miku993/Multiple-waveform-generators/image/电源/240V-12V AC-DC纹波图.jpg

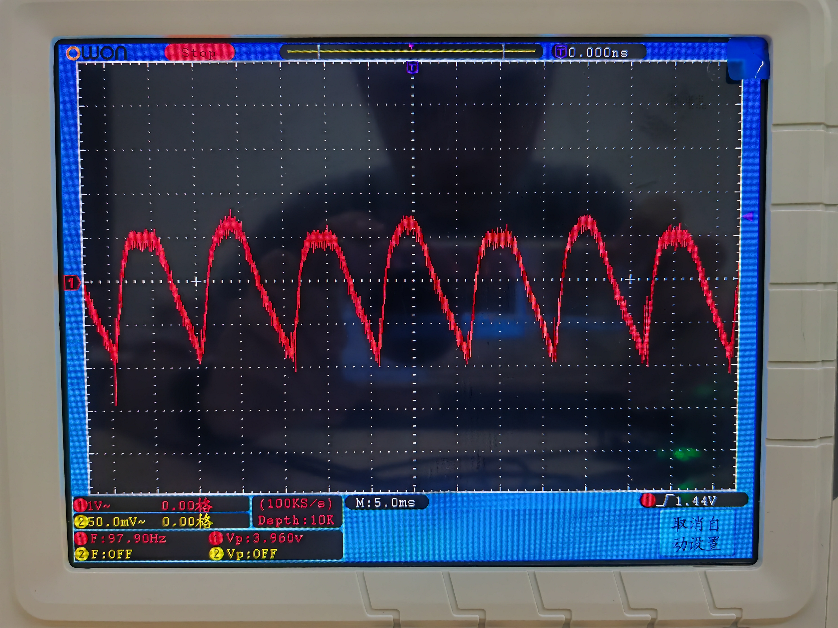
image/电源/240V-12V AC-DC纹波图.jpg
