miku993/Multiple-waveform-generators/image/正弦波/正弦波最低频率--15.5Hz.jpg

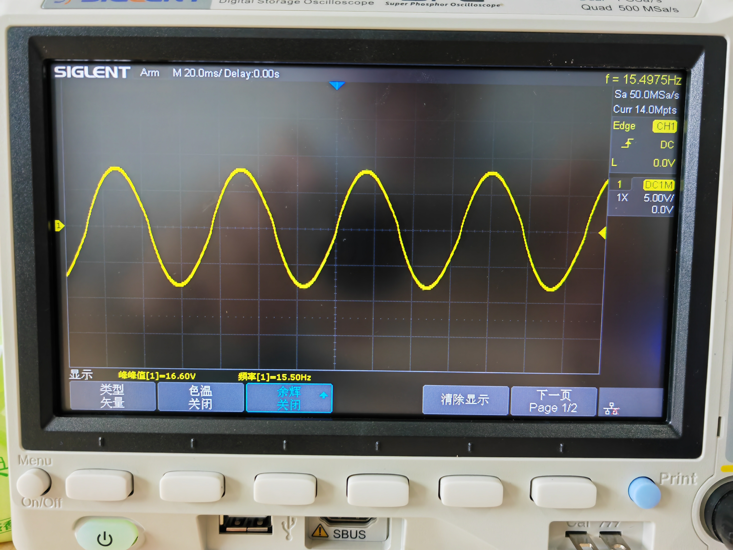
image/正弦波/正弦波最低频率--15.5Hz.jpg
