miku993/Multiple-waveform-generators/README.md

# 纯模电方法实现多种波形发生器
1. 输出波形工作频率范围为0.02Hz~20KHz，且连续可调。 
2. 正弦波Upp=3V，失真度小于1.5%，幅值连续可调。 
3. 方波幅值Upp=14V，幅值连续可调。 
4. 三角波Upp=5V，幅值连续可调  
### 基本功能可以实现，部分频段波形失真。工程包括仿真文件、pcb、原理图、论文，体系完备，有细致分析，全部免费开源。
