miku993/Multiple-waveform-generators/image/PCB+原理图+实物+仿真/PCB板实物图.jpg

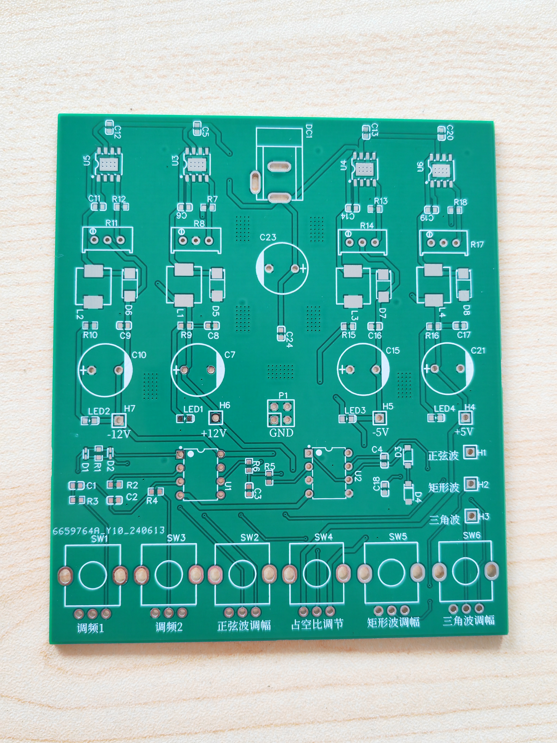
image/PCB+原理图+实物+仿真/PCB板实物图.jpg
