miku993/Multiple-waveform-generators/image/PCB+原理图+实物+仿真/PCB设计图.png

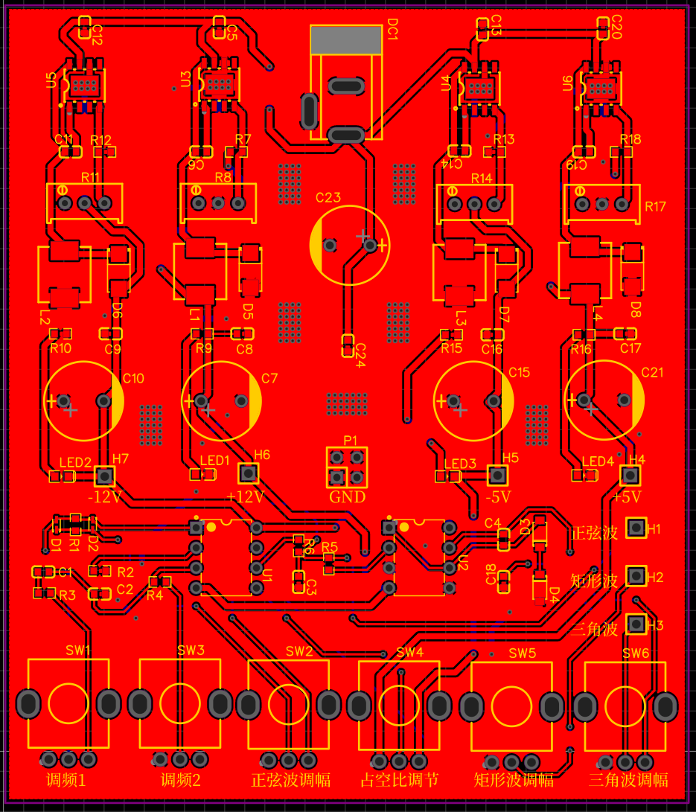
image/PCB+原理图+实物+仿真/PCB设计图.png
