miku993/Multiple-waveform-generators/image/多种波形叠加效果图.jpg

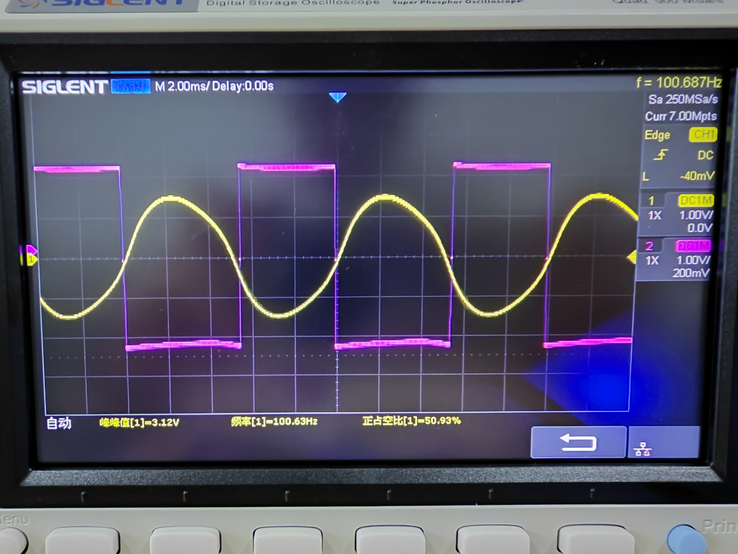
image/多种波形叠加效果图.jpg
