miku993/Multiple-waveform-generators/image/框图/电源框图.png

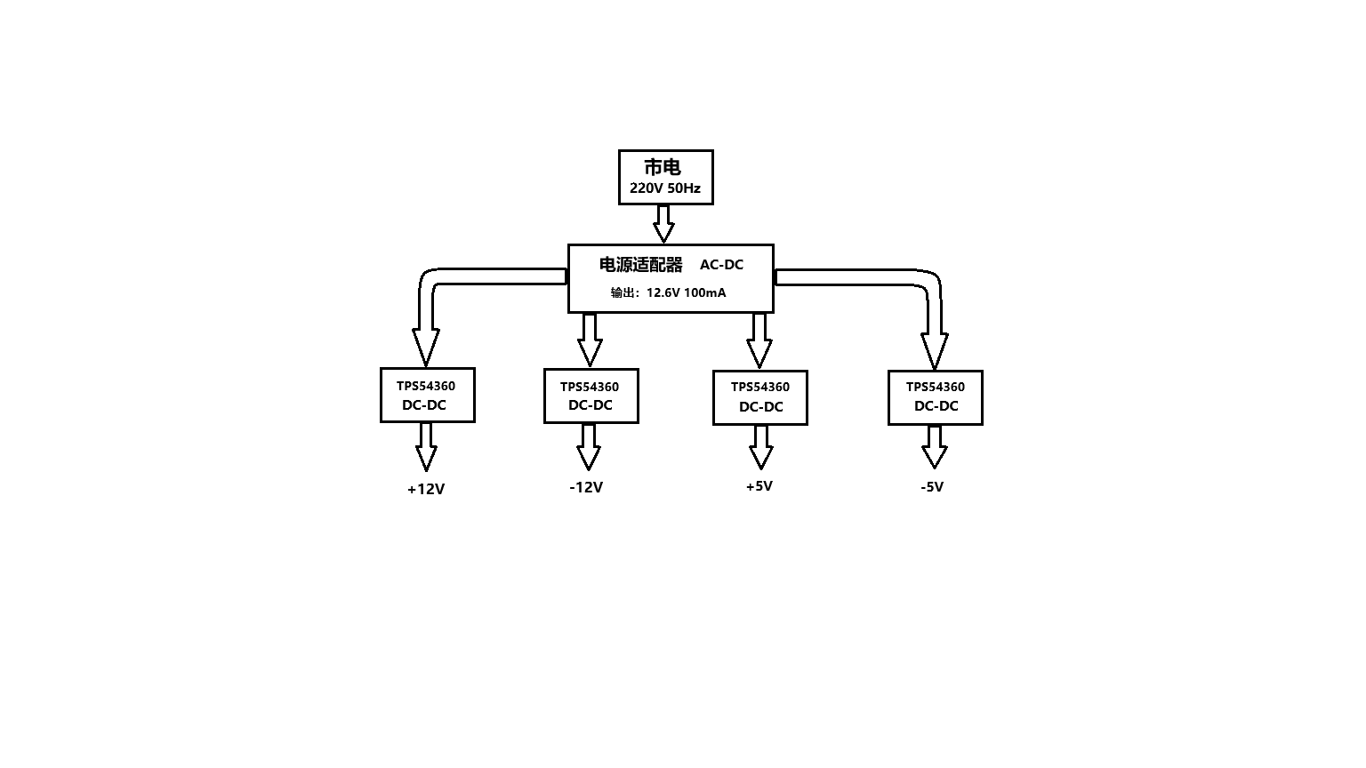
image/框图/电源框图.png
