miku993/Multiple-waveform-generators/image/框图/系统框图.png

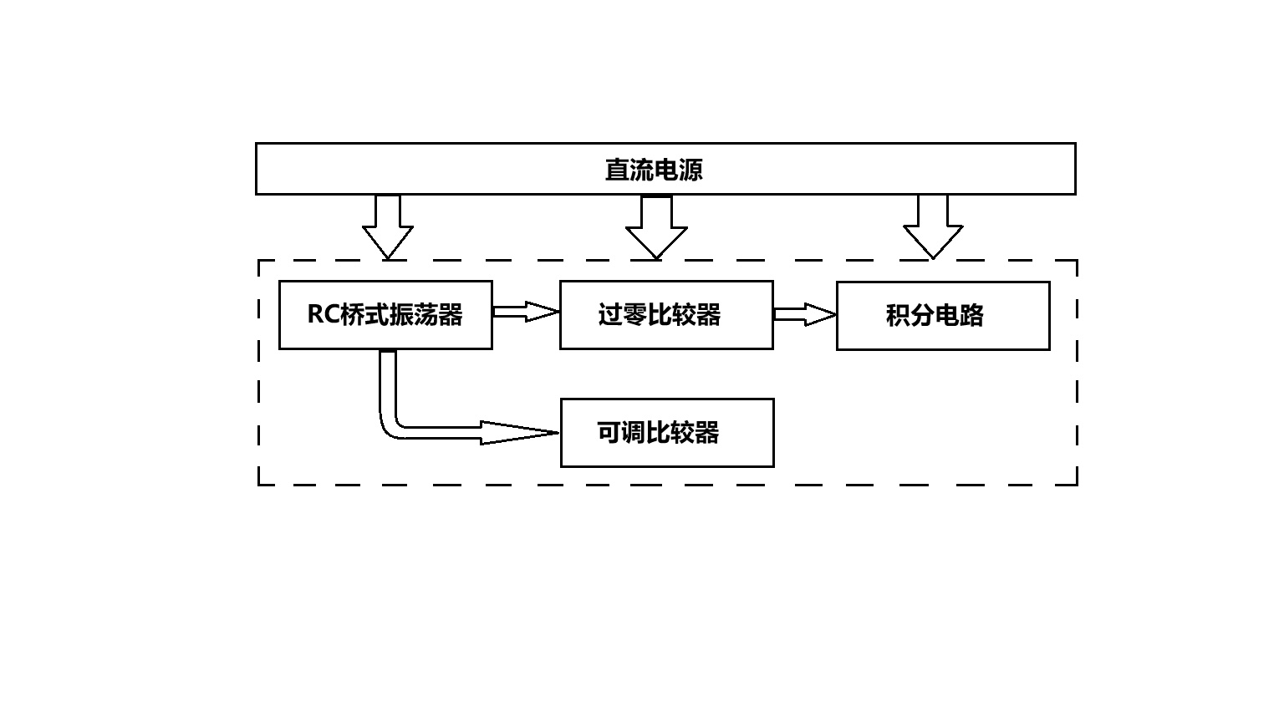
image/框图/系统框图.png
