miku993/Multiple-waveform-generators/pcb/BOM_多种信号发生器.csv

ID | Name | Designator | Footprint | Quantity | Manufacturer Part | Manufacturer | Supplier | Supplier Part | Price
1 | 100nF | C1,C2,C3,C5,C8,C9,C11,C12,C13,C14,C16,C17,C20,C24 | C0603 | 14
2 | 10nF | C4,C6,C19 | C0603 | 3
3 | 470uF | C7,C10,C15,C21,C23 | CAP-TH_BD10.0-P5.00-D1.0-FD | 5 | ERS1HM471G20OT | AISHI(艾华集团) | LCSC | C106666 | 0.6542
4 | 10uF | C18 | C0603 | 1
5 | 1N4148WT_C727112 | D1,D2 | SOD-523_L1.2-W0.8-LS1.6-RD | 2 | 1N4148WT | TWGMC(台湾迪嘉) | LCSC | C727112 | 0.0538
6 | DZL4734 | D3,D4 | SOD-123_L2.8-W1.8-LS3.7-RD | 2 | DZL4734 | LGE(鲁光) | LCSC | C362311 | 0.366
7 | SS34_C8678 | D5,D6,D7,D8 | SMA_L4.3-W2.6-LS5.2-RD | 4 | SS34 | MDD | LCSC | C8678 | 0.1663
8 | DC005_C431533 | DC1 | DC-IN-TH_DC005 | 1 | DC005 | SHOU HAN(首韩) | LCSC | C431533 | 0.2764
9 | PZ254V-11-01P | H1,H2,H3,H4,H5,H6,H7 | HDR-TH_1P-P2.54-V-M | 7 | PZ254V-11-01P | XFCN(兴飞) | LCSC | C492400 | 0.0811
10 | 10uH | L1,L2,L3,L4 | IND-SMD_L7.3-W6.8 | 4 | FXL0630-100-M | cjiang(长江微电) | LCSC | C167223 | 0.5242
11 | LED-0603_R | LED1,LED2,LED3,LED4 | LED0603_RED | 4 | 19-217/R6C-AL1M2VY/3T | EVERLIGHT(台湾亿光) | LCSC | C72044 | 0.1186
12 | Header-Male-2.54_2x2 | P1 | HDR-TH_4P-P2.54-V-M-R2-C2-S2.54-1 | 1 | 2.54-2*2P针 | BOOMELE(博穆精密) | LCSC | C66690 | 0.1438
13 | 20kΩ | R1 | R0603 | 1
14 | 10kΩ | R2,R5,R6,R7,R12,R13,R18 | R0603 | 7
15 | 68Ω | R3,R4 | R0603 | 2
16 | 10kΩ | R8,R11,R14,R17 | RES-ADJ-TH_3P-L10.0-W10.0-P2.50-L | 4 | 3296W-1-103 | BOCHEN(博晨) | LCSC | C118954 | 0.9352
17 | 1k | R9,R10,R15,R16 | R0603 | 4
18 | 100kΩ | SW1,SW3,SW4 | RES-ADJ-TH_RK09D1130C4G | 3 | RK09K1130AV7 | ALPSALPINE(阿尔卑斯阿尔派) | LCSC | C470296 | 3.46
19 | 20kΩ | SW2 | RES-ADJ-TH_RK09D1130C4G | 1 | RK09K1130AV7 | ALPSALPINE(阿尔卑斯阿尔派) | LCSC | C470296 | 3.46
20 | 10kΩ | SW5,SW6 | RES-ADJ-TH_RK09D1130C4G | 2 | RK09K1130AV7 | ALPSALPINE(阿尔卑斯阿尔派) | LCSC | C470296 | 3.46
21 | TPS5430DDAR | U3,U4,U5,U6 | ESOP-8_L4.9-W3.9-P1.27-LS6.0-TL-EP | 4 | TPS5430DDAR | TI(德州仪器) | LCSC | C9864 | 2.43
22 | OPA2134PA | U1,U2 | DIP-8_L9.6-W6.4-P2.54-LS7.6-BL-1 | 2 | OPA2134PA | TI(德州仪器) | LCSC | C1346118 | 3.52
