miku993/Multiple-waveform-generators/(list of files, drawings)

Other design files:
pcb/多种信号发生器.pcbdoc
pcb/多种信号发生器.schdoc
simulation/仿真文件.ms14
